hckim-dev/fpga-spi-sensor-monitoring/docs/assets/architecture/master.png

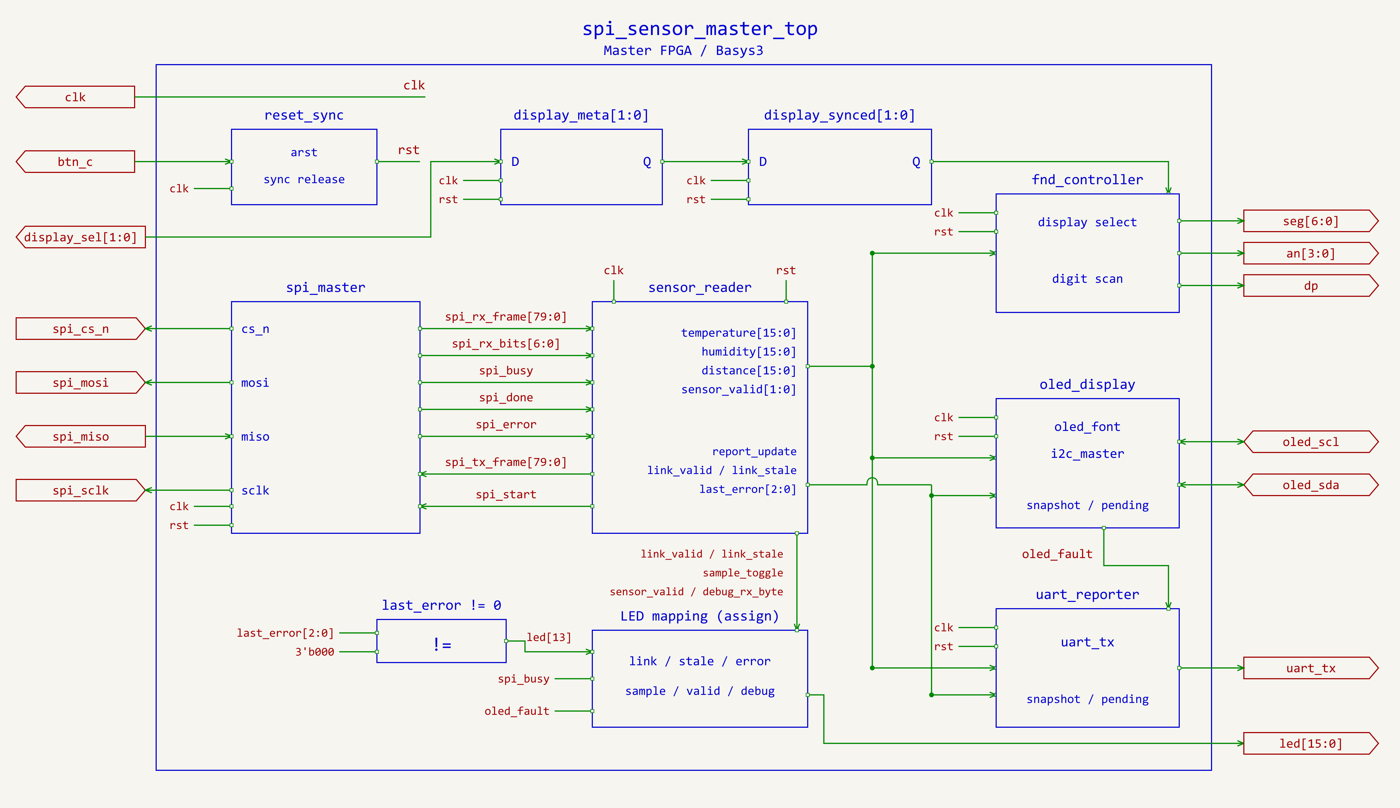
docs/assets/architecture/master.png
