hckim-dev/fpga-spi-sensor-monitoring/docs/assets/desktop/csv_export.png

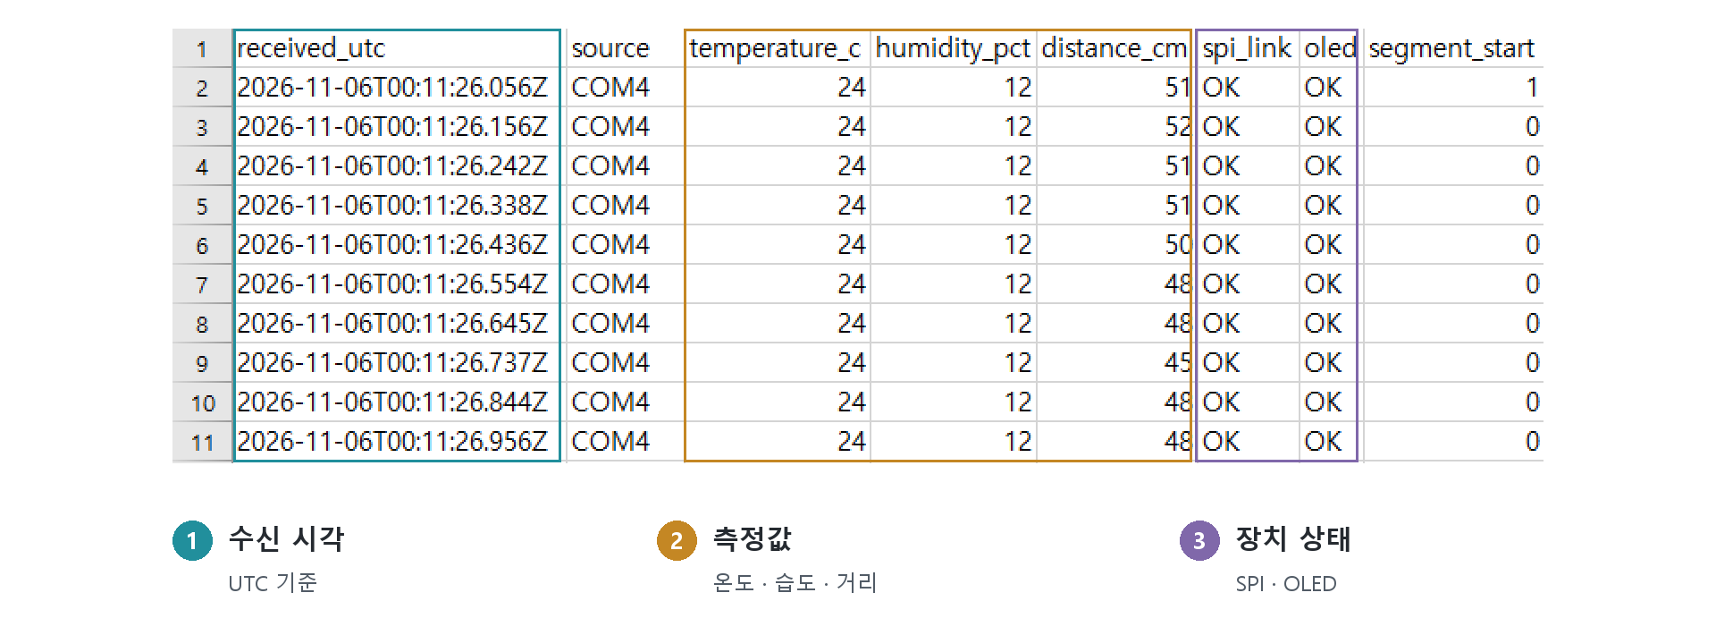
docs/assets/desktop/csv_export.png
