hckim-dev/fpga-spi-sensor-monitoring/docs/assets/fsm/sensor_reader.png

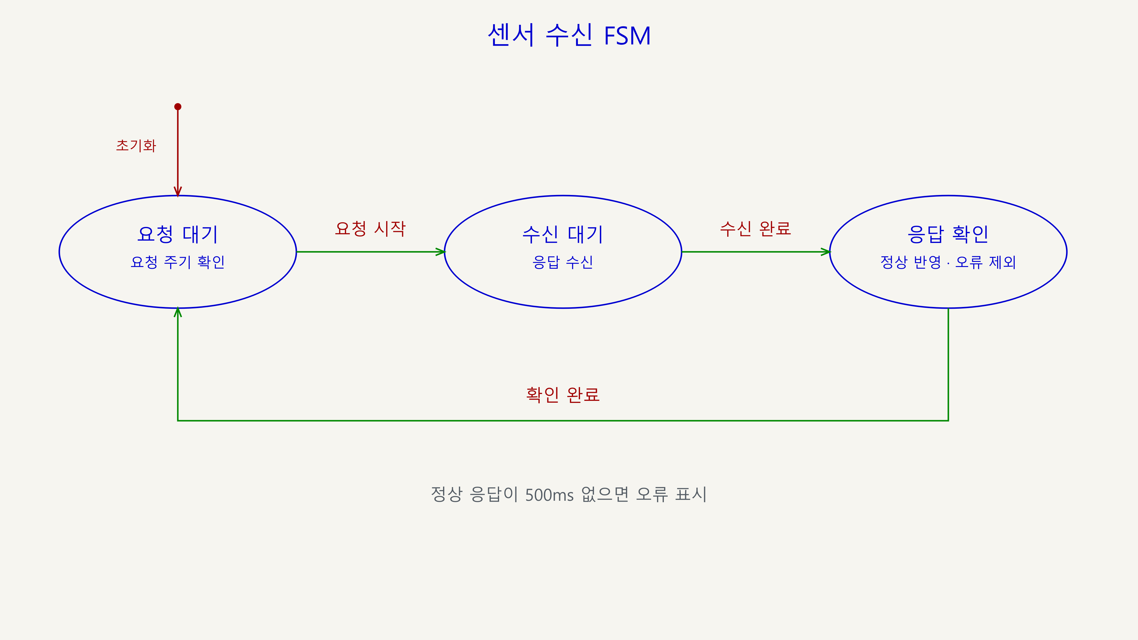
docs/assets/fsm/sensor_reader.png
