hckim-dev/fpga-spi-sensor-monitoring/docs/assets/fsm/spi_master.png

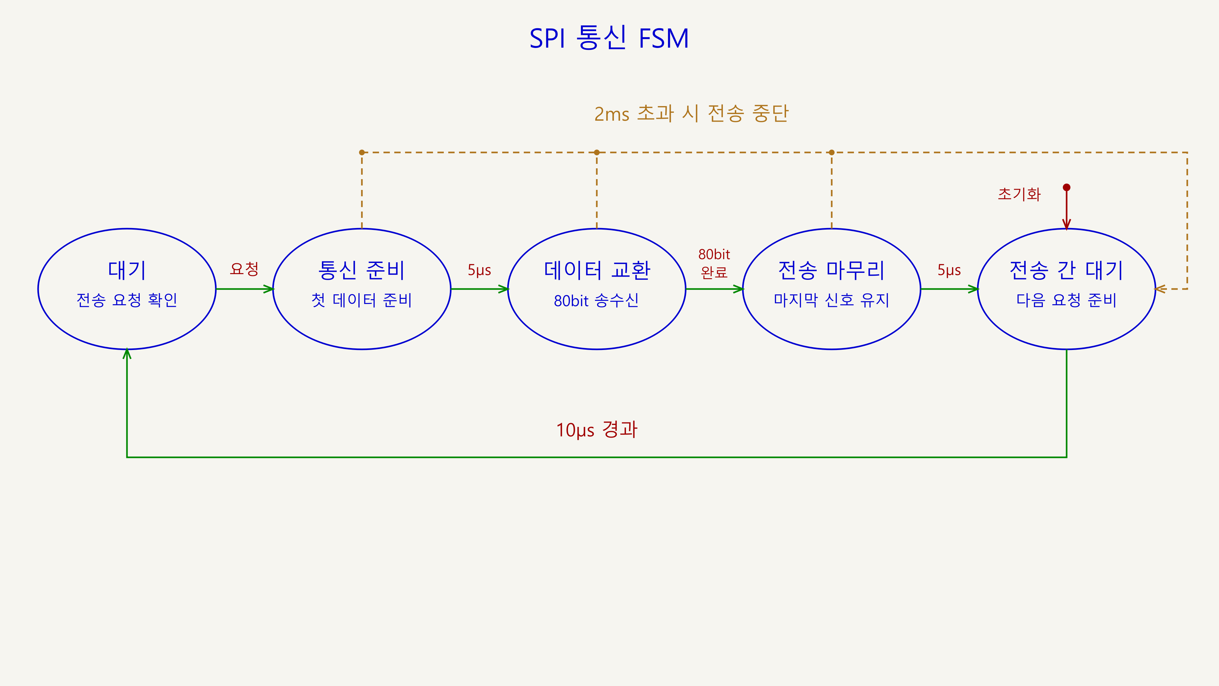
docs/assets/fsm/spi_master.png
