hckim-dev/fpga-spi-sensor-monitoring/docs/assets/protocol/spi_frame_g1.png

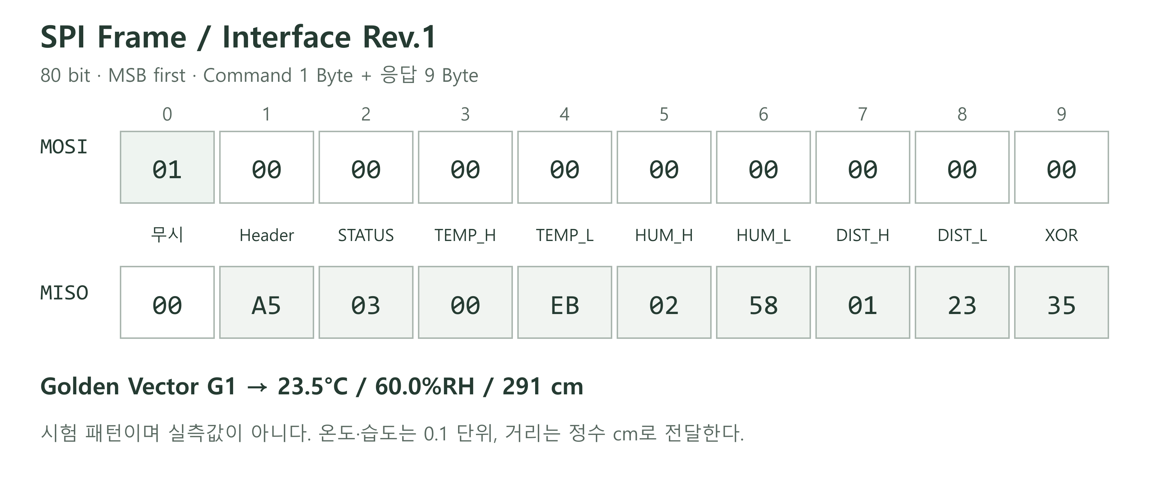
docs/assets/protocol/spi_frame_g1.png
