hckim-dev/fpga-spi-sensor-monitoring/docs/assets/status/spi_error_comparison.png

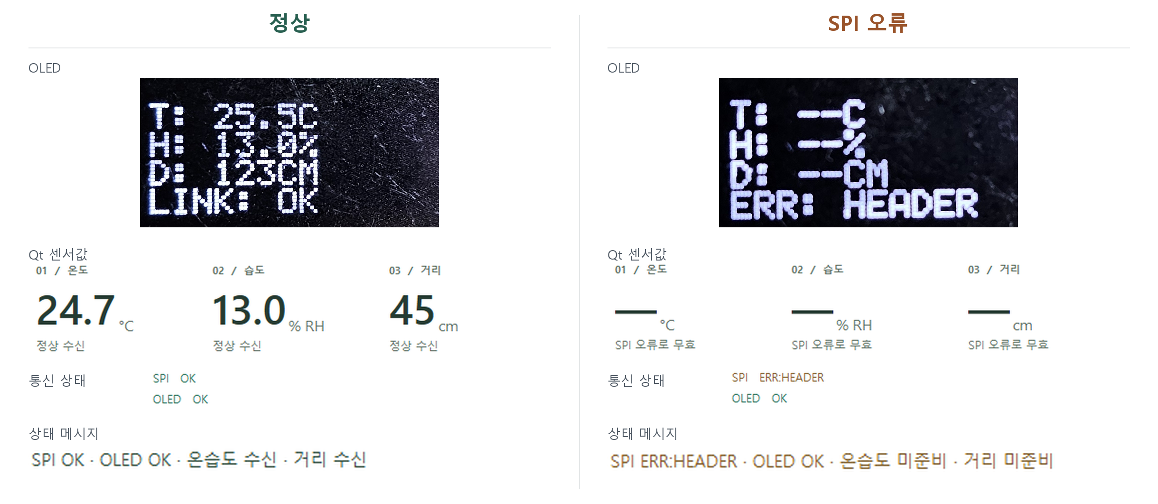
docs/assets/status/spi_error_comparison.png
