hckim-dev/fpga-spi-sensor-monitoring/docs/assets/verification/error_recovery.png

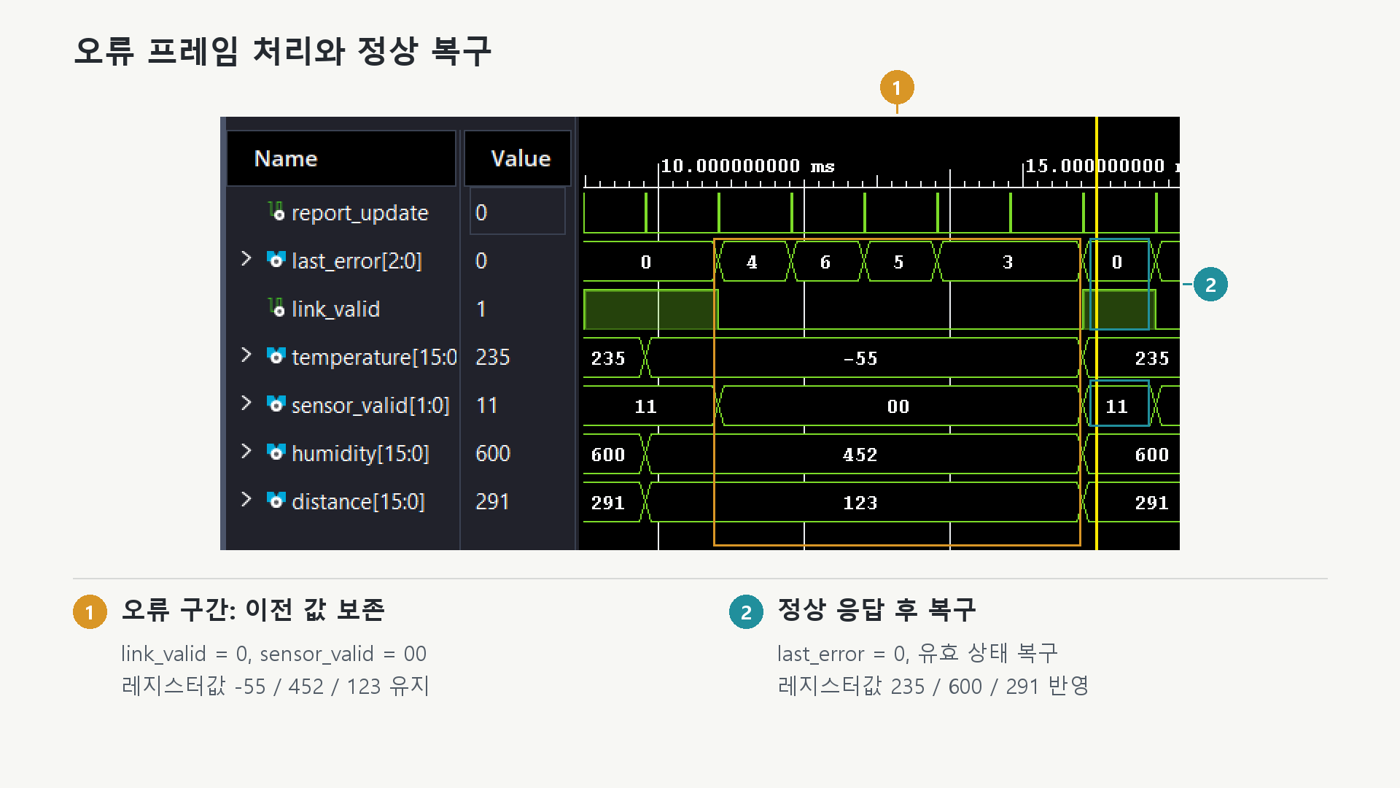
docs/assets/verification/error_recovery.png
