hckim-dev/fpga-spi-sensor-monitoring/docs/assets/verification/record_update.png

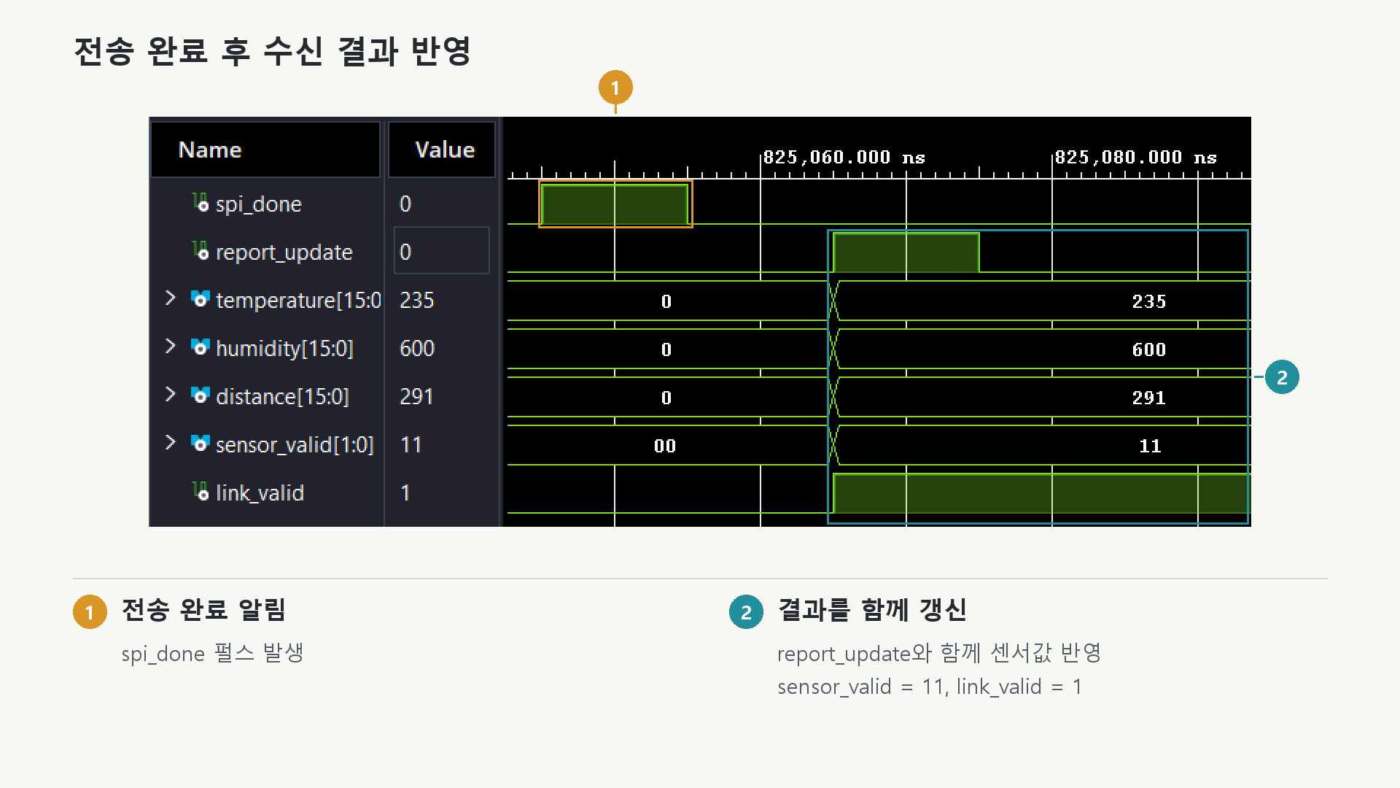
docs/assets/verification/record_update.png
