hckim-dev/fpga-spi-sensor-monitoring/docs/assets/verification/spi_receive_result.png

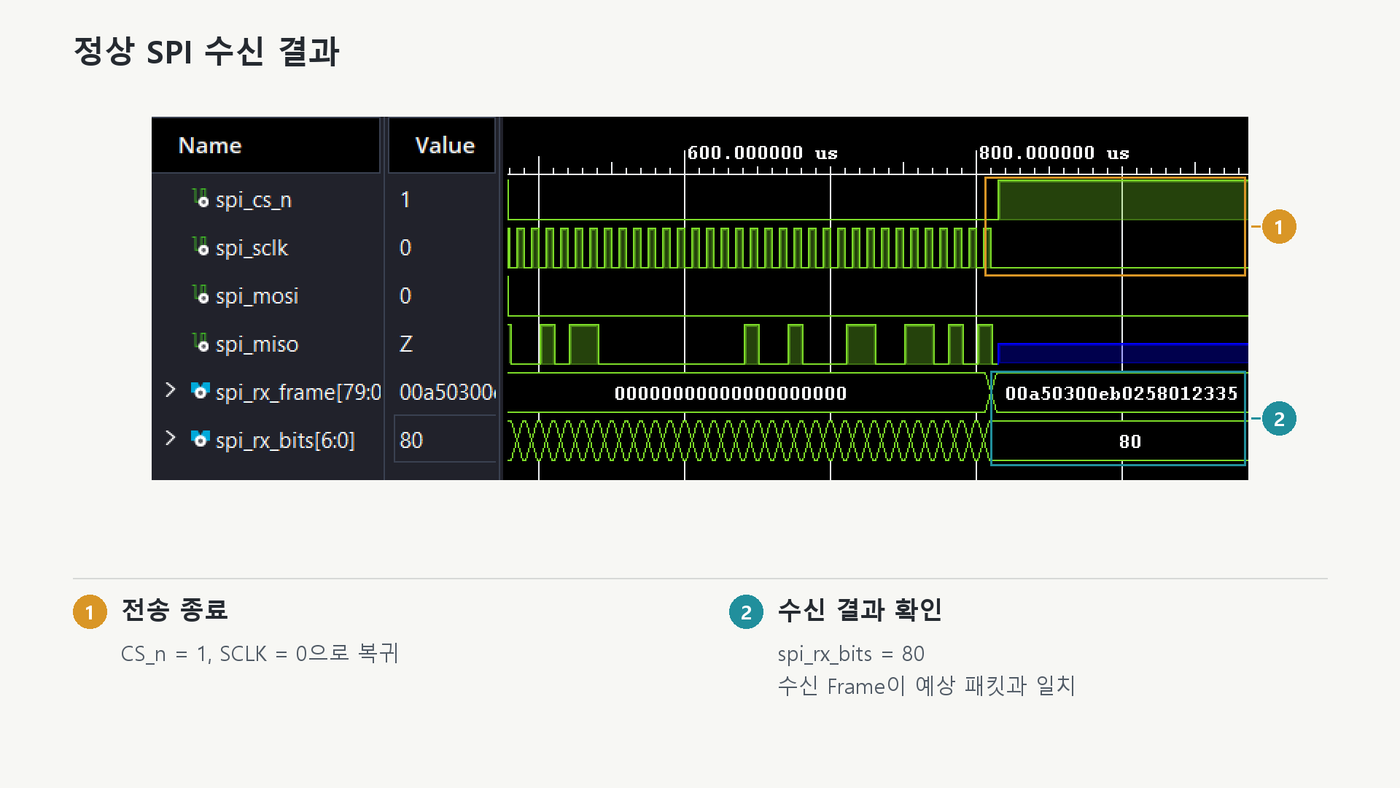
docs/assets/verification/spi_receive_result.png
