hckim-dev/fpga-spi-sensor-monitoring/(commit log)

2026-11-03 docs: establish SPI interface contract revision 1
2026-11-03 feat: implement and verify standalone SPI master
2026-11-03 feat: implement and verify sensor data transactions
2026-11-03 feat: add FND sensor display and integration tests
2026-11-03 feat: implement UART sensor status reporting
2026-11-03 feat: integrate board top reset inputs LEDs and constraints
    [Basys-3-Master.xdc, reset_sync.v, spi_sensor_master_top.v, tb_reset_sync.v, tb_spi_sensor_master_top.v, verify_spi_master.py]
2026-11-03 feat: implement and verify OLED I2C write transport
2026-11-03 feat(slave): integrate ultrasonic distance and SPI response
2026-11-03 Revert "feat(slave): integrate ultrasonic distance and SPI response"
    [Basys-3-Master.xdc, spi_slave.v, top.v, ultrasonic_sensor.v]
2026-11-04 Integrate Slave sensors and update Basys3 pin constraints
2026-11-04 포맷터 적용
2026-11-04 fix: match OLED initialization and layout to 128x32 panel
    [oled_display.v, ssd1306_model.v, tb_master_oled.v, tb_oled_display.v]
2026-11-04 Update Slave sensor display controller
2026-11-04 docs: record real ultrasonic SPI integration results
2026-11-04 Improve ultrasonic startup and add FND diagnostics
2026-11-04 Remove unused Slave UART test files
2026-11-04 feat: add Qt sensor monitoring desktop app
2026-11-05 fix: harden Qt monitoring logic and refine desktop UI
    [main.cpp, monitor_window.cpp, monitor_window.h, protocol.cpp, protocol.h, trend_plot.cpp, trend_plot.h]
2026-11-06 chore: 로컬 작업 파일 추적 제외
2026-11-06 docs: 구현·검증 이미지와 시연 영상 추가
2026-11-06 docs: 프로젝트 문서 재구성 및 기존 자료 정리
2026-11-06 docs: 발표자료 PDF 추가 및 README 연결
